relic-se/zero-stomp/README.md

# Zero Stomp
Programmable multi-effects guitar pedal based on the RP2040/RP2350-Zero and WM8960 audio codec. Supports CircuitPython 9.2+.

**More info coming soon!**
