relic-se/zero-stomp/hardware/3dmodels/STOMP-3PDT-LED/STOMP-3PDT-LED.step

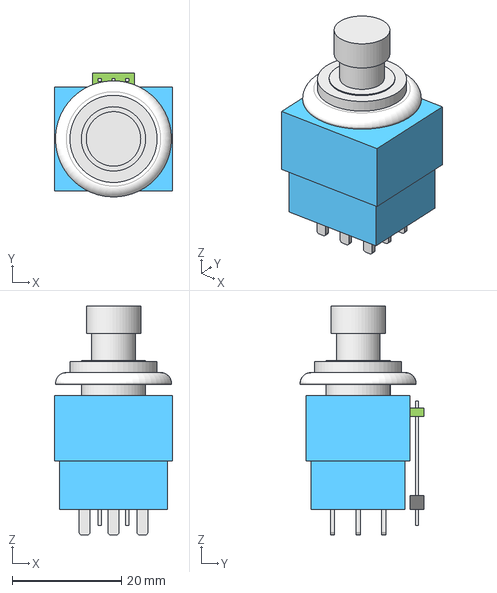
[picture p1: CAD file, 2024-10-11]
hardware/3dmodels/STOMP-3PDT-LED/STOMP-3PDT-LED.step
21.7 x 22.7 x 42.0 mm
