relic-se/zero-stomp/hardware/display-bezel/display-bezel.FCStd

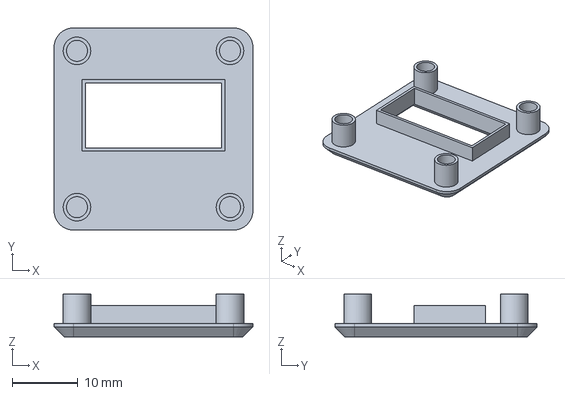
[picture p2: CAD file, 2025-01-20]
hardware/display-bezel/display-bezel.FCStd
30.3 x 30.8 x 6.50 mm
