relic-se/zero-stomp/hardware/drill-guide/drill-guide.FCStd

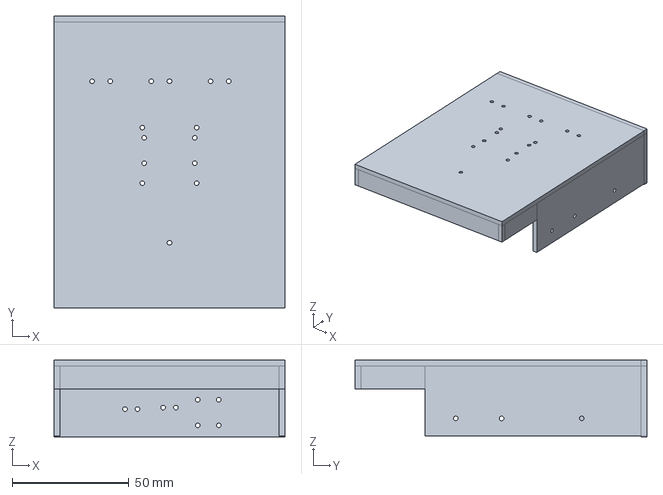
[picture p3: CAD file, 2025-01-20]
hardware/drill-guide/drill-guide.FCStd
99.0 x 125.0 x 33.0 mm
