relic-se/zero-stomp/(list of files, cad)

Other CAD files:
hardware/3dmodels/STOMP-3PDT-LED/STOMP-3PDT-LED.FCStd
hardware/display-bezel/display-bezel.stl
hardware/drill-guide/drill-guide.stl
