relic-se/zero-stomp/hardware/Zero-Stomp.kicad_pcb

## KiCad design hardware/Zero-Stomp.kicad_pcb (2025-01-20)

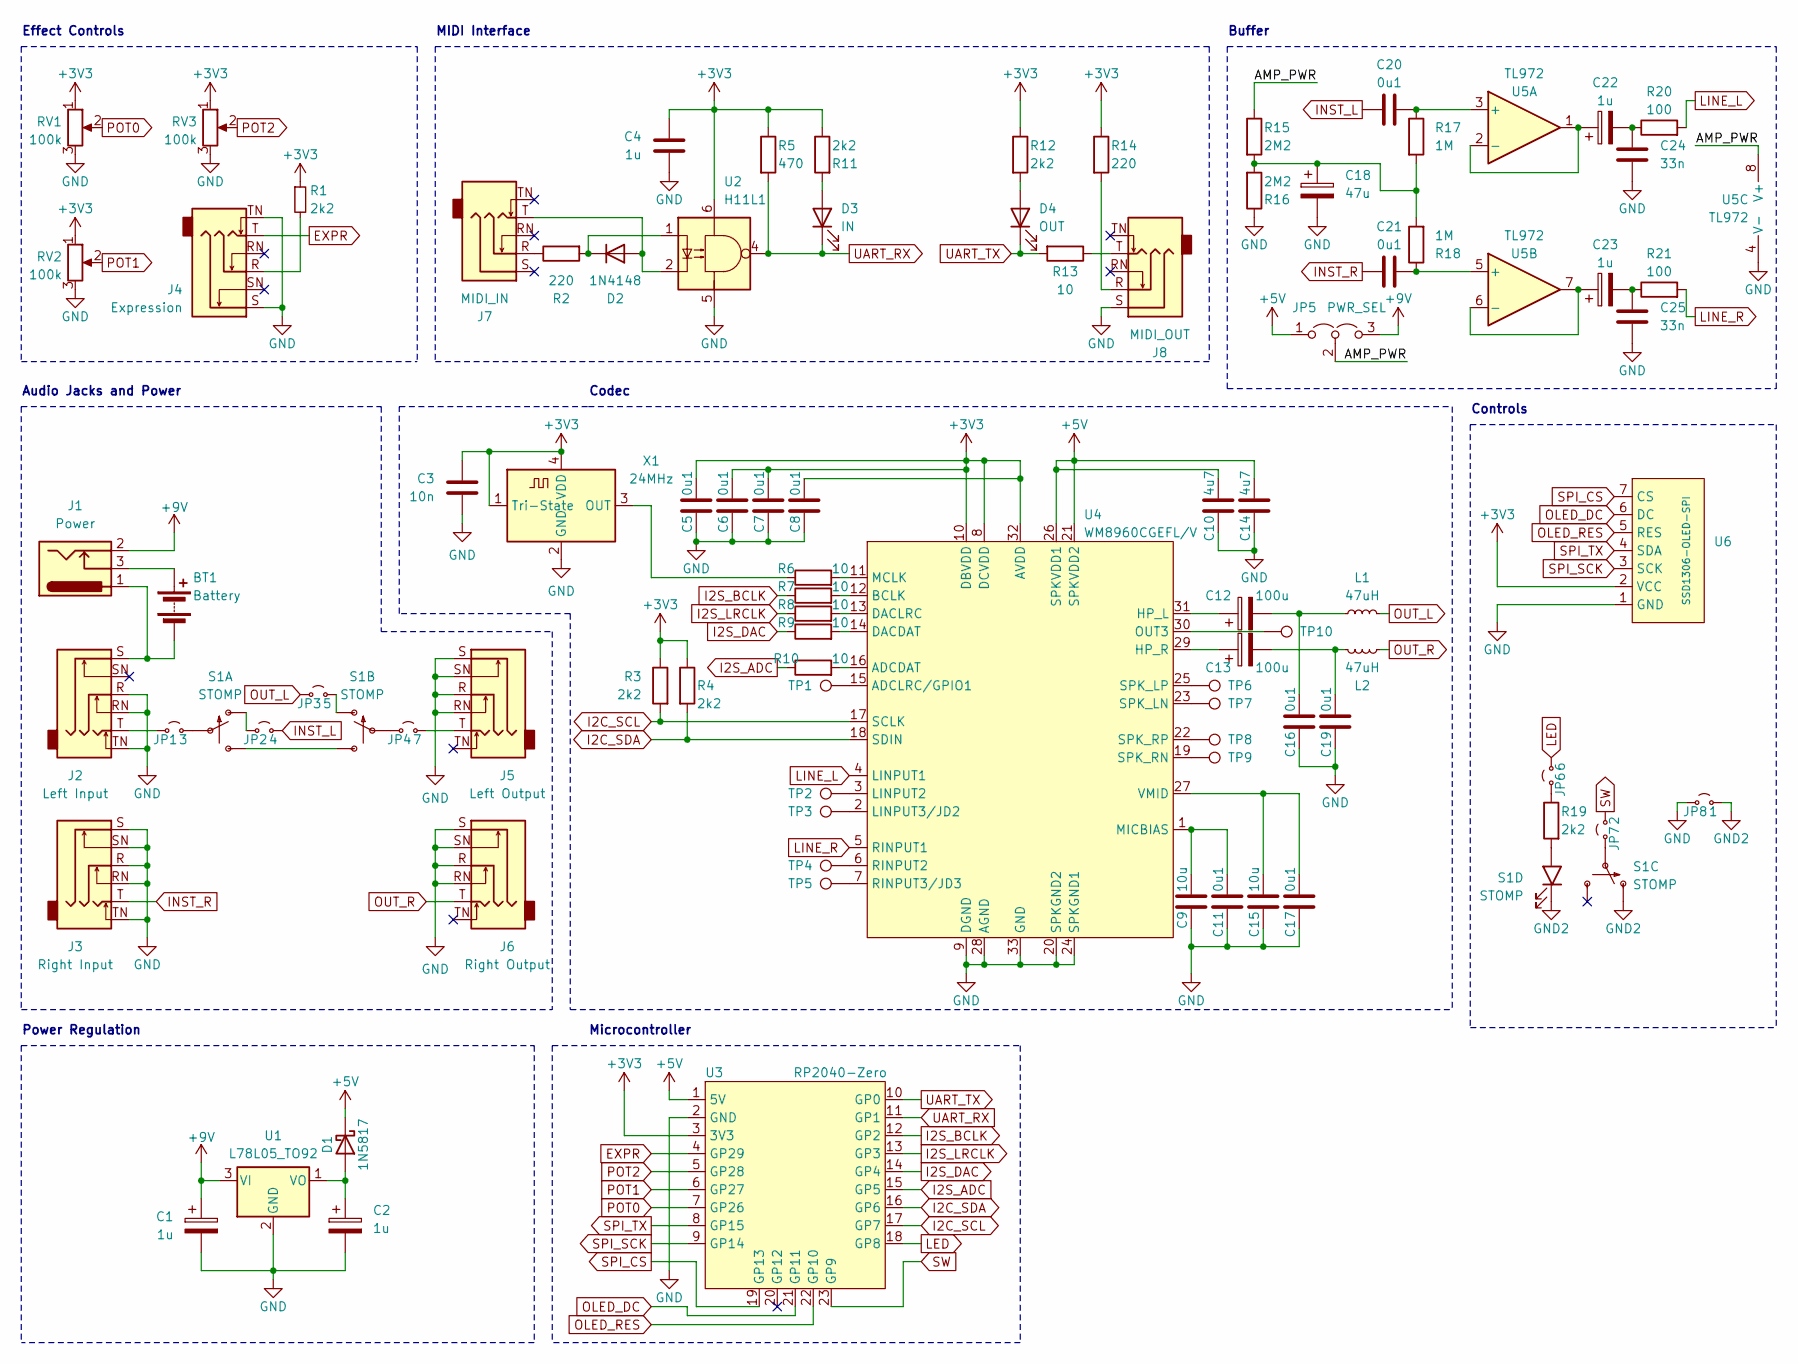
[picture p4: schematic Zero-Stomp.kicad_sch]

Parts:
BT1: Battery; PinHeader_1x02_P2.54mm_Vertical
C1, C2, C22, C23: 1u; CP_Radial_D5.0mm_P2.00mm
C3: 10n; C_0805_2012Metric_Pad1.18x1.45mm_HandSolder
C4: 1u; C_Rect_L4.0mm_W2.5mm_P2.50mm
C5, C6, C7, C8, C11, C17: 0u1; C_0805_2012Metric_Pad1.18x1.45mm_HandSolder
C9, C15: 10u; C_0805_2012Metric_Pad1.18x1.45mm_HandSolder
C10, C14: 4u7; C_0805_2012Metric_Pad1.18x1.45mm_HandSolder
C12, C13: 100u; CP_Radial_D6.3mm_P2.50mm
C16, C19, C20, C21: 0u1; C_Rect_L4.0mm_W2.5mm_P2.50mm
C18: 47u; CP_Radial_D5.0mm_P2.00mm
C24, C25: 33n; C_Rect_L4.0mm_W2.5mm_P2.50mm
D1: 1N5817; D_DO-41_SOD81_P2.54mm_Vertical_AnodeUp
D2: 1N4148; D_DO-35_SOD27_P2.54mm_Vertical_AnodeUp
D3: IN; LED_D3.0mm
D4: OUT; LED_D3.0mm
J1: Power; BarrelJack_Horizontal
J2: Left Input; Jack_6.35mm_Neutrik_NMJ6HFD2_Horizontal
J3: Right Input; Jack_6.35mm_Neutrik_NMJ6HFD2_Horizontal
J4: Expression; Jack_6.35mm_Neutrik_NMJ6HFD2_Horizontal
J5: Left Output; Jack_6.35mm_Neutrik_NMJ6HFD2_Horizontal
J6: Right Output; Jack_6.35mm_Neutrik_NMJ6HFD2_Horizontal
J7: MIDI_IN; Jack_3.5mm_CUI_SJ1-3525N_Horizontal
J8: MIDI_OUT; Jack_3.5mm_CUI_SJ1-3525N_Horizontal
JP1: 3; Jumper_2_THT_P2.54mm
JP2: 4; Jumper_2_THT_P2.54mm
JP3: 5; Jumper_2_THT_P2.54mm
JP4: 7; Jumper_2_THT_P2.54mm
JP5: PWR_SEL; PinHeader_1x03_P2.54mm_Vertical
JP6: 6; Jumper_2_THT_P2.54mm
JP7: 2; Jumper_2_THT_P2.54mm
JP8: 1; Jumper_2_THT_P2.54mm
L1, L2: 47uH; L_Axial_L6.6mm_D2.7mm_P2.54mm_Vertical_Vishay_IM-2
R1, R11, R12, R19: 2k2; R_Axial_DIN0207_L6.3mm_D2.5mm_P2.54mm_Vertical
R2, R14: 220; R_Axial_DIN0207_L6.3mm_D2.5mm_P2.54mm_Vertical
R3, R4: 2k2; R_0805_2012Metric_Pad1.20x1.40mm_HandSolder
R5: 470; R_Axial_DIN0207_L6.3mm_D2.5mm_P2.54mm_Vertical
R6, R7, R8, R9, R10: 10; R_0805_2012Metric_Pad1.20x1.40mm_HandSolder
R13: 10; R_Axial_DIN0207_L6.3mm_D2.5mm_P2.54mm_Vertical
R15, R16: 2M2; R_Axial_DIN0207_L6.3mm_D2.5mm_P2.54mm_Vertical
R17, R18: 1M; R_Axial_DIN0207_L6.3mm_D2.5mm_P2.54mm_Vertical
R20, R21: 100; R_Axial_DIN0207_L6.3mm_D2.5mm_P2.54mm_Vertical
RV1, RV2, RV3: 100k; Potentiometer_Omeg_PC16BU_Vertical
S1: STOMP; STOMP-3PDT-LED
TP1, TP2, TP3, TP4, TP5, TP6, TP7, TP8, TP9, TP10: TestPoint; TestPoint_Pad_D1.5mm
U1: L78L05_TO92; TO-92_Inline
U2: H11L1; DIP-6_W7.62mm
U3: RP2040-Zero; RP2040 Zero
U4: WM8960CGEFL/V; QFN-32-1EP_5x5mm_P0.5mm_EP3.3x3.3mm_ThermalVias
U5: TL972; DIP-8_W7.62mm
U6: SSD1306-OLED-SPI; SSD1306-OLED-SPI-0.96
X1: 24MHz; Oscillator_SMD_ECS_2520MV-xxx-xx-4Pin_2.5x2.0mm

Connections:
+3V3: C3.1, C4.1, C5.1, C6.1, C7.1, C8.1, R1.1, R3.1, R4.1, R5.1, R11.1, R12.1, R14.1, RV1.1, RV2.1, RV3.1, U2.6, U3.3 (3V3), U4.8 (DCVDD), U4.10 (DBVDD), U4.32 (AVDD), U6.2 (VCC), X1.1 (Tri-State), X1.4 (VDD)
+5V: C10.1, C14.1, D1.1 (K), JP5.1 (A), U3.1 (5V), U4.21 (SPKVDD2), U4.26 (SPKVDD1)
+9V: C1.1, J1.2, JP5.3 (B), U1.3 (VI)
/AMP_PWR: JP5.2 (C), R15.1, U5.8 (V+)
EXPR: J4.T, U3.4 (GP29)
GND: C1.2, C2.2, C3.2, C4.2, C5.2, C6.2, C7.2, C8.2, C9.2, C10.2, C11.2, C14.2, C15.2, C16.2, C17.2, C18.2, C19.2, C24.2, C25.2, J2.R, J2.RN, J2.TN, J3.R, J3.RN, J3.S, J3.SN, J3.TN, J4.S, J4.TN, J5.R, J5.RN, J5.S, J5.SN, J6.R, J6.RN, J6.S, J6.SN, J8.S, JP8.1 (A), R16.1, RV1.3, RV2.3, RV3.3, U1.2 (GND), U2.5, U3.2 (GND), U4.9 (DGND), U4.20 (SPKGND2), U4.24 (SPKGND1), U4.28 (AGND), U4.33 (GND), U5.4 (V-), U6.1 (GND), X1.2 (GND)
GND2: JP8.2 (B), S1.P$7 (O), S1.P$11 (K)
I2C_SCL: R3.2, U3.17 (GP7), U4.17 (SCLK)
I2C_SDA: R4.2, U3.16 (GP6), U4.18 (SDIN)
I2S_ADC: R10.1, U3.15 (GP5)
I2S_BCLK: R7.1, U3.12 (GP2)
I2S_DAC: R9.1, U3.14 (GP4)
I2S_LRCLK: R8.1, U3.13 (GP3)
INST_L: C20.1, JP2.2 (B)
INST_R: C21.1, J3.T
LED: JP6.2 (B), U3.18 (GP8)
LINE_L: R20.2, U4.4 (LINPUT1)
LINE_R: R21.2, U4.5 (RINPUT1)
unnamed: BT1.1 (+), J1.3
unnamed: BT1.2 (-), J1.1, J2.S
unnamed: C12.2, C16.1, L1.2
unnamed: C13.2, C19.1, L2.2
unnamed: C18.1, R15.2, R16.2, R17.2, R18.2
unnamed: C22.2, C24.1, R20.1
unnamed: C23.2, C25.1, R21.1
unnamed: C2.1, D1.2 (A), U1.1 (VO)
unnamed: D2.2 (A), J7.T, U2.2
unnamed: D2.1 (K), R2.2, U2.1
unnamed: D3.2 (A), R11.2
unnamed: D4.2 (A), R12.2
unnamed: J4.R, R1.2
unnamed: J7.R, R2.1
unnamed: J8.R, R14.2
unnamed: J8.T, R13.1
unnamed: J2.T, JP1.1 (A)
unnamed: JP1.2 (B), S1.P$2
unnamed: JP2.1 (A), S1.P$1 (O)
unnamed: JP3.2 (B), S1.P$4 (O)
unnamed: JP4.1 (A), S1.P$5
unnamed: J5.T, JP4.2 (B)
unnamed: JP6.1 (A), R19.1
unnamed: JP7.1 (A), S1.P$8
unnamed: S1.P$3 (S), S1.P$6 (S)
unnamed: R19.2, S1.P$10 (A)
unnamed: R10.2, U4.16 (ADCDAT)
unnamed: TP1.1, U4.15 (ADCLRC/GPIO1)
unnamed: R7.2, U4.12 (BCLK)
unnamed: R9.2, U4.14 (DACDAT)
unnamed: R8.2, U4.13 (DACLRC)
unnamed: C12.1, U4.31 (HP_L)
unnamed: C13.1, U4.29 (HP_R)
unnamed: TP2.1, U4.3 (LINPUT2)
unnamed: TP3.1, U4.2 (LINPUT3/JD2)
unnamed: R6.2, U4.11 (MCLK)
unnamed: C9.1, C11.1, U4.1 (MICBIAS)
unnamed: TP10.1, U4.30 (OUT3)
unnamed: TP4.1, U4.6 (RINPUT2)
unnamed: TP5.1, U4.7 (RINPUT3/JD3)
unnamed: TP7.1, U4.23 (SPK_LN)
unnamed: TP6.1, U4.25 (SPK_LP)
unnamed: TP9.1, U4.19 (SPK_RN)
unnamed: TP8.1, U4.22 (SPK_RP)
unnamed: C15.1, C17.1, U4.27 (VMID)
unnamed: C20.2, R17.1, U5.3 (+)
unnamed: C22.1, U5.1, U5.2 (-)
unnamed: C21.2, R18.1, U5.5 (+)
unnamed: C23.1, U5.6 (-), U5.7
unnamed: R6.1, X1.3 (OUT)
OLED_DC: U3.21 (GP11), U6.6 (DC)
OLED_RES: U3.22 (GP10), U6.5 (RES)
OUT_L: JP3.1 (A), L1.1
OUT_R: J6.T, L2.1
POT0: RV1.2, U3.7 (GP26)
POT1: RV2.2, U3.6 (GP27)
POT2: RV3.2, U3.5 (GP28)
SPI_CS: U3.19 (GP13), U6.7 (CS)
SPI_SCK: U3.9 (GP14), U6.3 (SCK)
SPI_TX: U3.8 (GP15), U6.4 (SDA)
SW: JP7.2 (B), U3.23 (GP9)
UART_RX: D3.1 (K), R5.2, U2.4, U3.11 (GP1)
UART_TX: D4.1 (K), R13.2, U3.10 (GP0)

Notes on the sheet:
MIDI Interface
Effect Controls
Microcontroller
Buffer
Codec
Audio Jacks and Power
Power Regulation
Controls

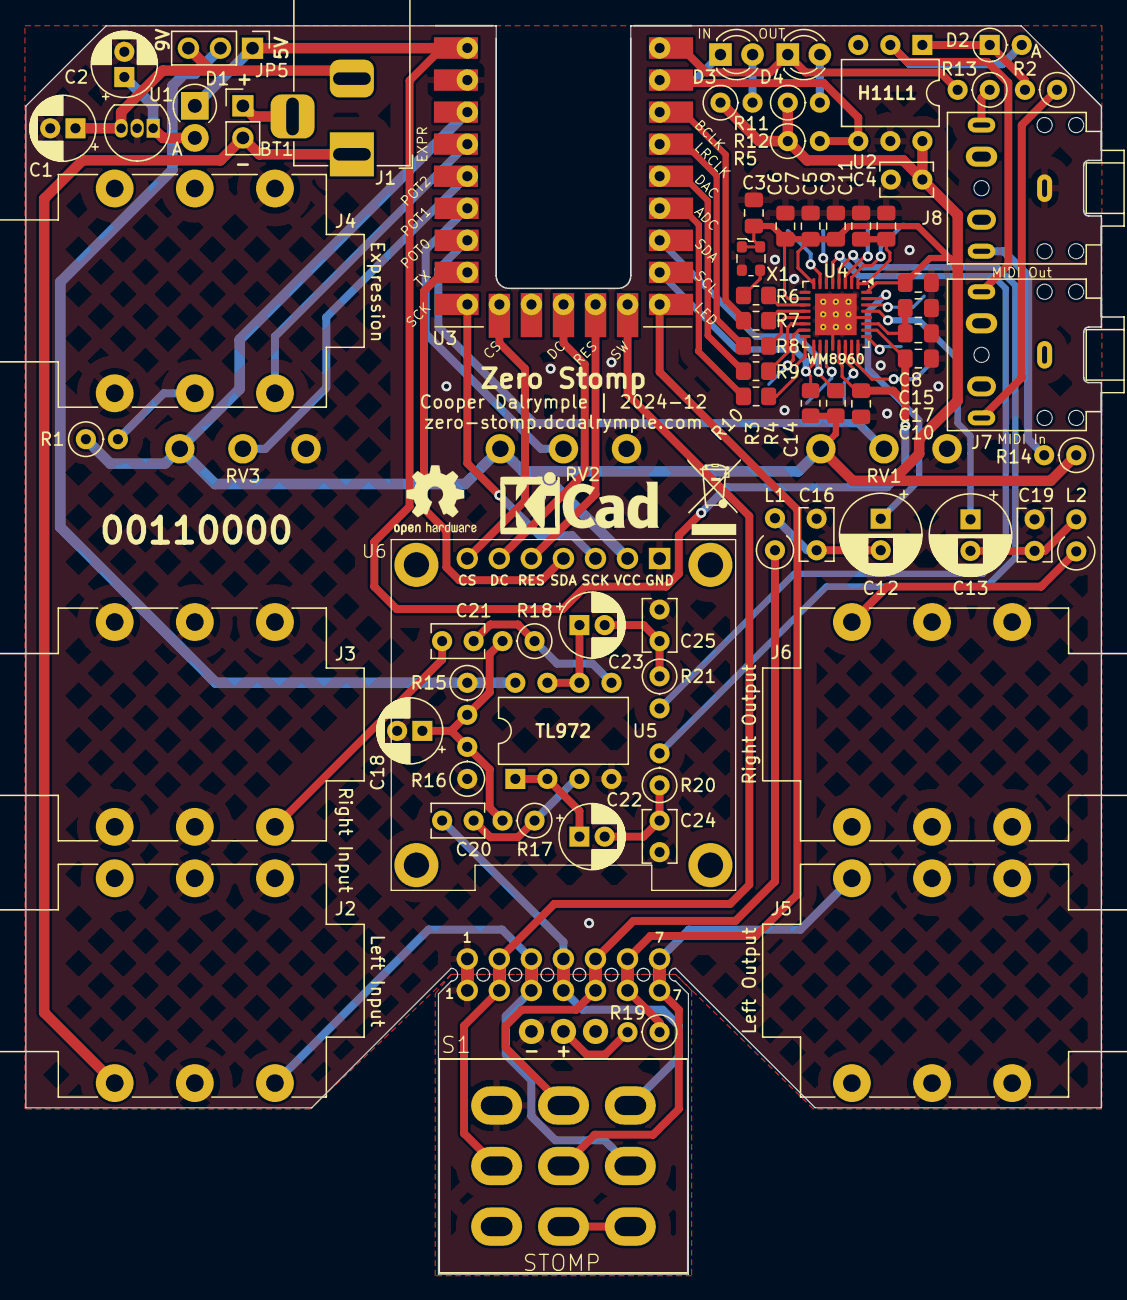
[picture p5: board Zero-Stomp.kicad_pcb from above]

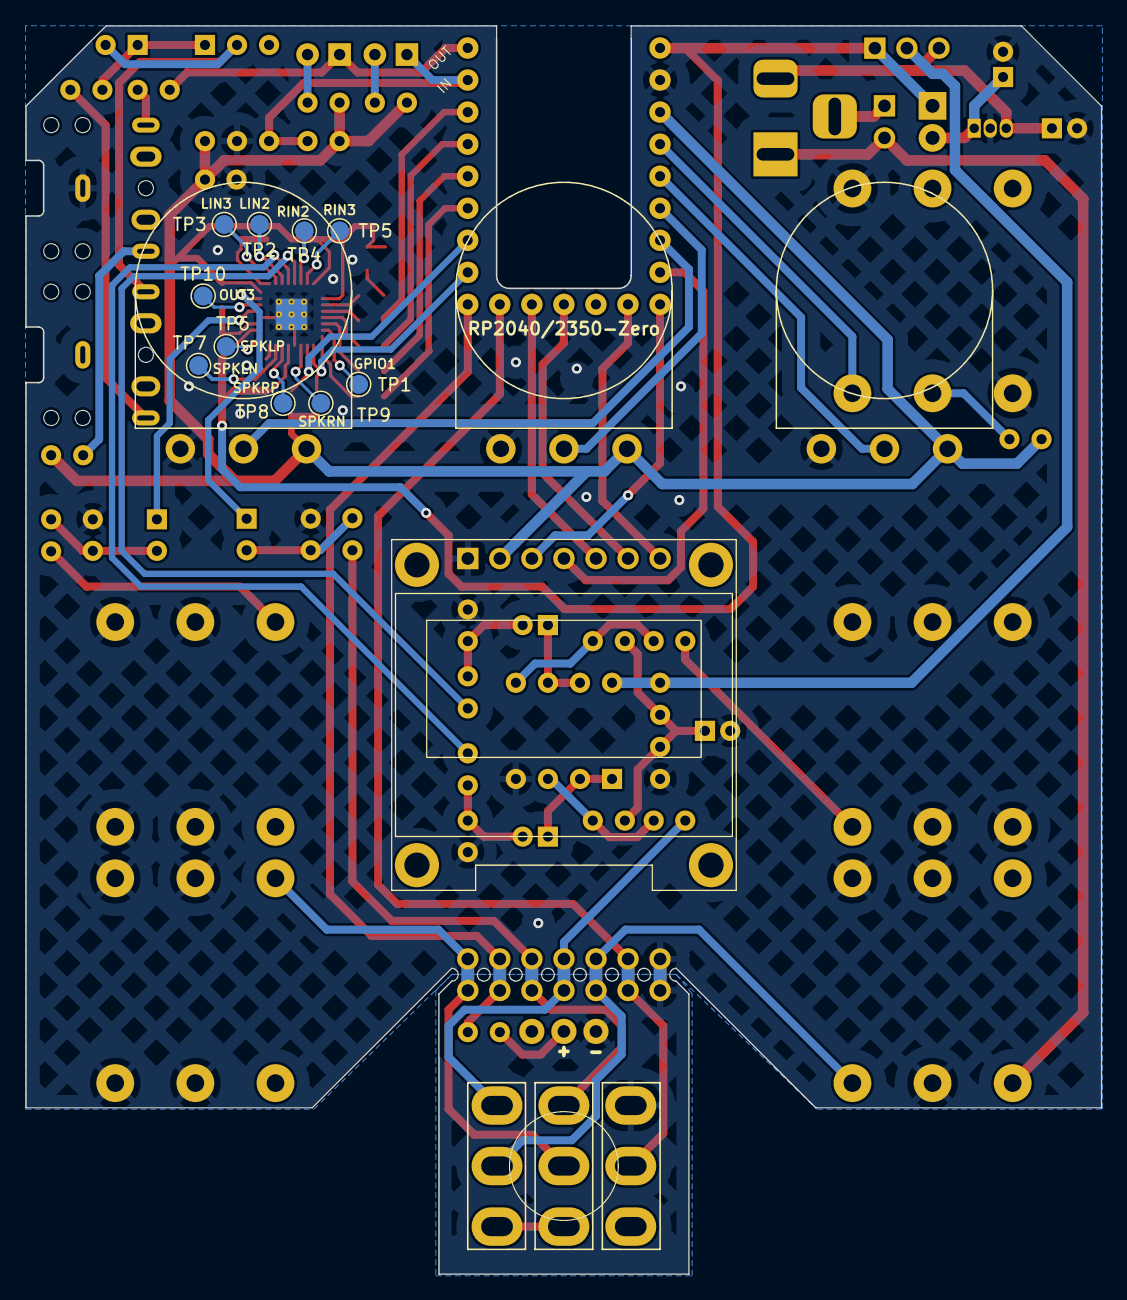
[picture p6: board Zero-Stomp.kicad_pcb from below]

Board: 2 copper layers, 85.2 x 98.9 mm, 91 parts (15 on the bottom side), 81 nets.

Other parts of the board:
3D?: HAMMOND-1590BB
