relic-se/zero-stomp/circuitpython/apps/delay.py

# SPDX-FileCopyrightText: Copyright (c) 2024 Cooper Dalrymple
#
# SPDX-License-Identifier: GPLv3

# NOTE: Currently not supported as of CircuitPython 9.2.1

import audiodelays
import audiofilters
import synthio

import zero_stomp
zero_stomp.CURRENT = __file__

# Constants
TAPE_LENGTH = 100
FILTER = False

MIN_DELAY = 10
MAX_DELAY = 1000
MAX_EXPRESSION = 500

MIN_SPEED = 0.1
MAX_SPEED = 10.0

MAX_SCALE = 0.25

MIN_FILTER = 100
MAX_FILTER = 20000

# Device configuration
device = zero_stomp.ZeroStomp()
device.title = "Delay"
device.mix = 0.5

# Audio Objects
delay_ms = synthio.Math(
    synthio.MathOperation.SCALE_OFFSET,
    0.0, # Expression Amount
    MAX_EXPRESSION,
    250 # Delay Value
)
delay_effect = audiodelays.Echo(
    max_delay_ms=TAPE_LENGTH,
    delay_ms=synthio.Math(
        synthio.MathOperation.SCALE_OFFSET,
        synthio.LFO(scale=0.0),
        delay_ms,
        delay_ms
    ),
    mix=1.0,
    freq_shift=True,
    
    sample_rate=zero_stomp.SAMPLE_RATE,
    channel_count=zero_stomp.CHANNELS,
    buffer_size=zero_stomp.BUFFER_SIZE,
    samples_signed=zero_stomp.SAMPLES_SIGNED,
    bits_per_sample=zero_stomp.BITS_PER_SAMPLE,
)

# Assign controls
device.assign_knob("Mix", device, "mix")
device.assign_knob("Regen", delay_effect, "decay")
device.assign_knob("Delay", delay_ms, "c", MIN_DELAY, MAX_DELAY)

device.assign_knob("Speed", delay_effect.delay_ms.a, "rate", MIN_SPEED, MAX_SPEED)
device.assign_knob("Width", delay_effect.delay_ms.a, "scale", 0.0, MAX_SCALE)

if FILTER:
    filter_effect = audiofilters.Filter(
        filter=synthio.BlockBiquad(synthio.FilterMode.LOW_PASS, MAX_FILTER),
        sample_rate=zero_stomp.SAMPLE_RATE,
        channel_count=zero_stomp.CHANNELS,
    )

    device.assign_knob("Filter", filter_effect.filter, "frequency", MIN_FILTER, MAX_FILTER)

    # Audio Chain
    device.i2s.play(filter_effect)
    filter_effect.play(delay_effect)
    delay_effect.play(device.i2s, loop=True)

else:
    # Audio Chain
    device.i2s.play(delay_effect)
    delay_effect.play(device.i2s)

# Update Loop
while True:
    device.update()
    delay_ms.a = device.expression
    device.led = 0 if device.bypassed else (delay_effect.delay_ms.a.value + 1) / 4 + 0.5
