relic-se/zero-stomp/(commit log)

2024-10-11 Added RP2040-Zero-KiCAD submodule.
2024-10-11 Added custom libraries and 3d models.
    [1590A-Top.step, 1590A.FCStd, STOMP-3PDT-LED.FCStd, STOMP-3PDT-LED.step]
2024-12-17 Initial hardware design completed.
    [1590A-Top.step, 1590A.FCStd, Zero-Stomp.kicad_pcb, Zero-Stomp.kicad_sch]
2024-12-17 Move hardware design into subfolder.
    [STOMP-3PDT-LED.FCStd, STOMP-3PDT-LED.step, Zero-Stomp.kicad_pcb, Zero-Stomp.kicad_sch]
2024-12-18 Move CircuitPython firmware into subfolder.
2024-12-19 Improved knob, switch, and led control systems.
2025-01-20 Added 3d print models.
    [display-bezel.FCStd, display-bezel.stl, drill-guide.FCStd, drill-guide.stl]
2025-01-20 Various bug fixes and I2S implementation.
    [delay.py, tremolo.py, tuner.py, zero_stomp.py]
2025-01-20 Minor adjustments to hardware design.
    [Zero-Stomp.kicad_pcb, Zero-Stomp.kicad_sch]
2025-01-20 Add samples signed constant.
2025-01-20 Increase led pwm frequency to prevent audible noise in output.
    [zero_stomp.py]
2025-01-21 Fix app switching.
2025-01-23 Change device usb label.
2025-01-23 Reduce time of short click duration.
    [zero_stomp.py]
2025-01-23 Initial arduino test using AudioTools library.
2025-01-24 Updated arduino firmware to use dedicated library.
2025-01-24 Remove arduino example.
2025-01-24 Add arduino library as submodule.
